nebularnoise/rp2040macro/models/base.FCStd

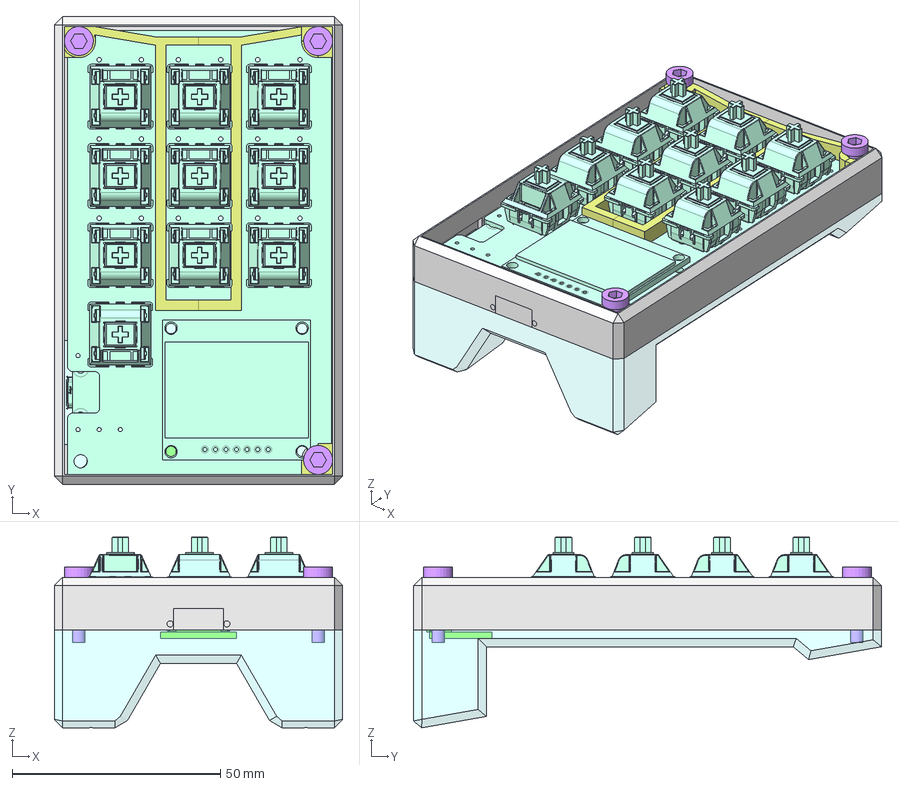
[picture p1: CAD file, 2022-07-17]
models/base.FCStd
69.3 x 112.5 x 45.8 mm
Sides
Base
Support
USB_C_Module
Sides_usb_C
Base_usb_c
Column001
Column002
Column003
Screw001
Screw002
Screw003
macropad001
