nebularnoise/rp2040macro/models/screen-Part.step

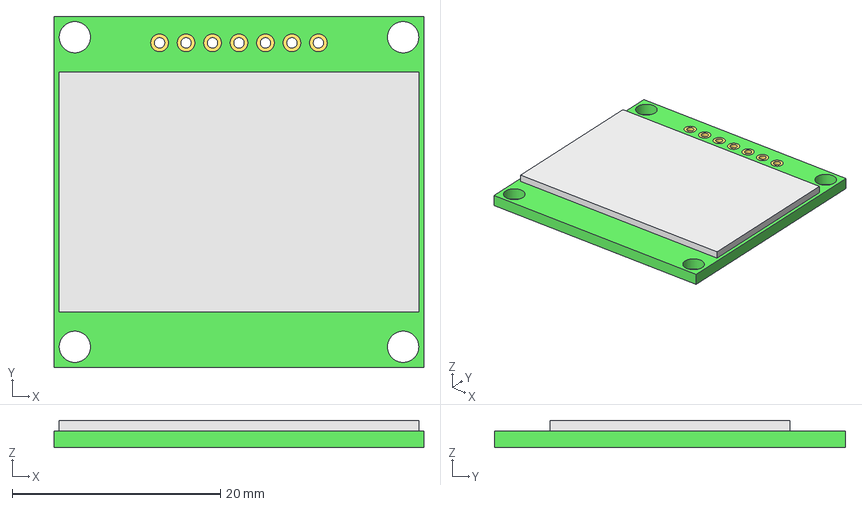
[picture p2: CAD file, 2022-07-10]
models/screen-Part.step
35.5 x 33.7 x 2.60 mm
