nebularnoise/rp2040macro/models/screen.FCStd

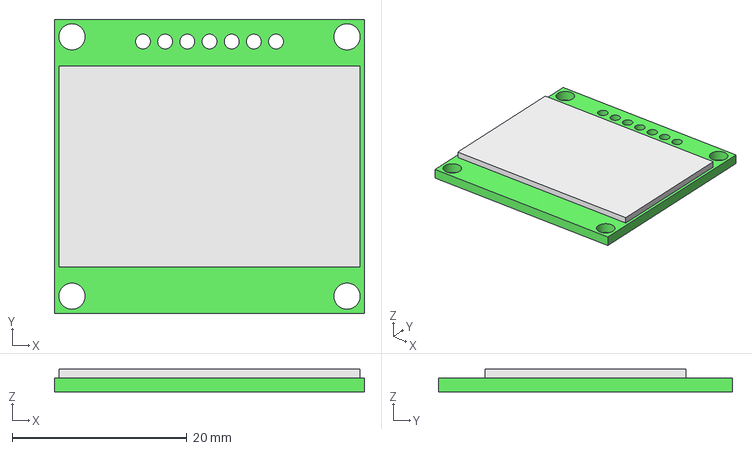
[picture p3: CAD file, 2022-06-10]
models/screen.FCStd
35.5 x 33.7 x 2.60 mm
