nebularnoise/rp2040macro/hardware/macropad.kicad_pcb

## KiCad design hardware/macropad.kicad_pcb (2022-07-10)

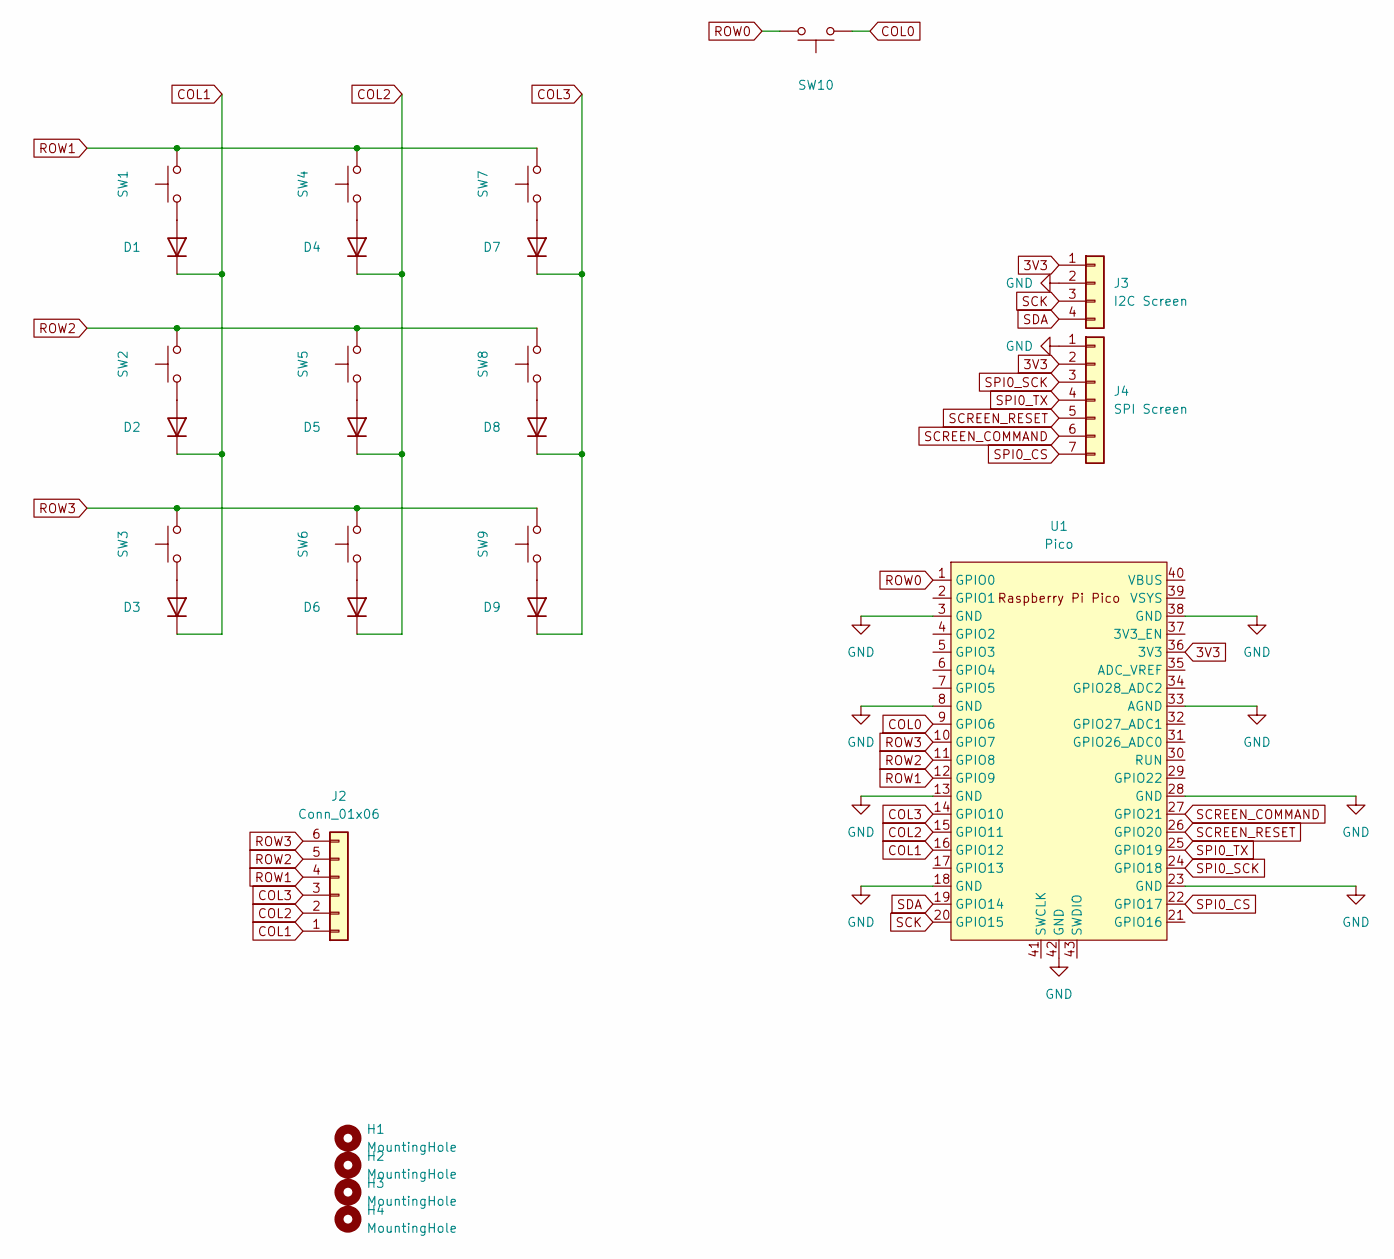
[picture p4: schematic macropad.kicad_sch]

Parts:
D1, D2, D3, D4, D5, D6, D7, D8, D9: D; D_DO-41_SOD81_P10.16mm_Horizontal
H1, H2, H3, H4: MountingHole; MountingHole_3.2mm_M3
J2: Conn_01x06; PinHeader_1x06_P2.54mm_Vertical
J3: I2C Screen; I2C_1.3inch_OLED
J4: SPI Screen; SPI_1.3inch_OLED
SW1, SW2, SW3, SW4, SW5, SW6, SW7, SW8, SW9, SW10: SW_Push; SW_Hotswap_Kailh_MX
U1: Pico; RPi_Pico_SMD_TH

Connections:
3V3: J3.1, J4.2, U1.36 (3V3)
COL0: SW10.2, U1.9 (GPIO6)
COL1: D1.1 (K), D2.1 (K), D3.1 (K), J2.1, U1.16 (GPIO12)
COL2: D4.1 (K), D5.1 (K), D6.1 (K), J2.2, U1.15 (GPIO11)
COL3: D7.1 (K), D8.1 (K), D9.1 (K), J2.3, U1.14 (GPIO10)
GND: J3.2, J4.1, U1.3 (GND), U1.8 (GND), U1.13 (GND), U1.18 (GND), U1.23 (GND), U1.28 (GND), U1.33 (AGND), U1.38 (GND), U1.42 (GND)
unnamed: D1.2 (A), SW1.2
unnamed: D2.2 (A), SW2.2
unnamed: D3.2 (A), SW3.2
unnamed: D4.2 (A), SW4.2
unnamed: D5.2 (A), SW5.2
unnamed: D6.2 (A), SW6.2
unnamed: D7.2 (A), SW7.2
unnamed: D8.2 (A), SW8.2
unnamed: D9.2 (A), SW9.2
ROW0: SW10.1, U1.1 (GPIO0)
ROW1: J2.4, SW1.1, SW4.1, SW7.1, U1.12 (GPIO9)
ROW2: J2.5, SW2.1, SW5.1, SW8.1, U1.11 (GPIO8)
ROW3: J2.6, SW3.1, SW6.1, SW9.1, U1.10 (GPIO7)
SCK: J3.3, U1.20 (GPIO15)
SCREEN_COMMAND: J4.6, U1.27 (GPIO21)
SCREEN_RESET: J4.5, U1.26 (GPIO20)
SDA: J3.4, U1.19 (GPIO14)
SPI0_CS: J4.7, U1.22 (GPIO17)
SPI0_SCK: J4.3, U1.24 (GPIO18)
SPI0_TX: J4.4, U1.25 (GPIO19)

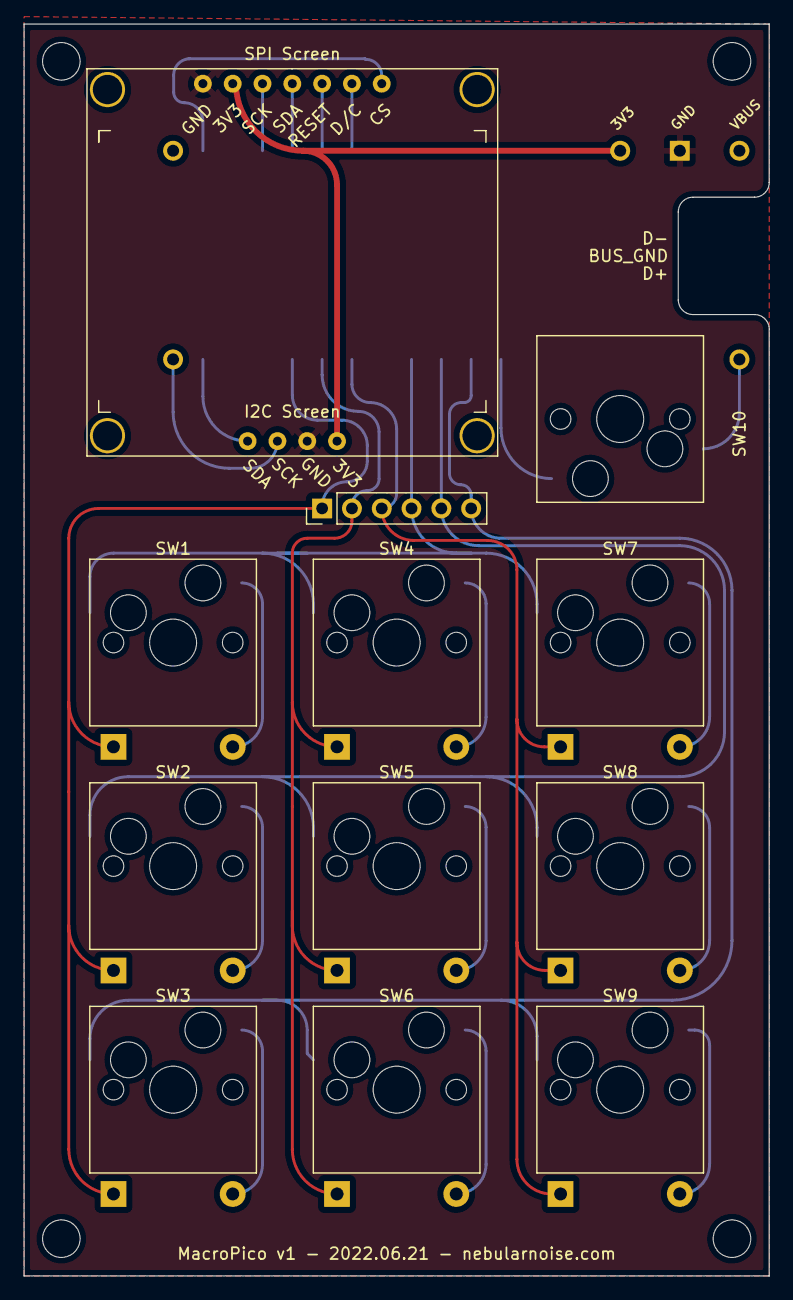
[picture p5: board macropad.kicad_pcb from above]

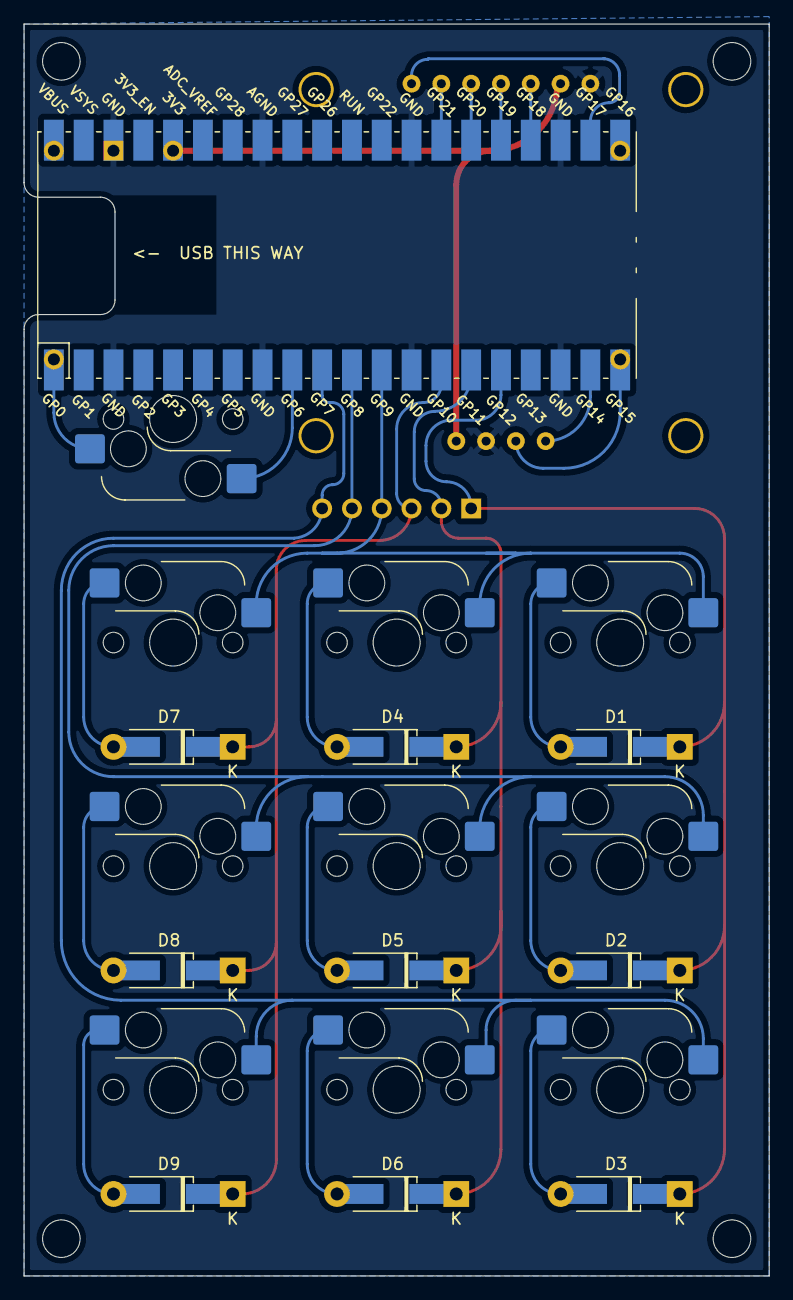
[picture p6: board macropad.kicad_pcb from below]

Board: 2 copper layers, 63.5 x 106.7 mm, 27 parts (10 on the bottom side), 26 nets.
