nebularnoise/rp2040macro/firmware/kmk/extensions/peg_rgb_matrix.py

import neopixel

from storage import getmount

from kmk.extensions import Extension
from kmk.handlers.stock import passthrough as handler_passthrough
from kmk.keys import make_key


class Color:
    OFF = [0, 0, 0]
    WHITE = [249, 249, 249]
    RED = [255, 0, 0]
    BLUE = [0, 0, 255]
    GREEN = [0, 255, 0]
    YELLOW = [255, 247, 0]
    ORANGE = [255, 77, 0]
    PURPLE = [255, 0, 242]
    TEAL = [0, 128, 128]
    PINK = [255, 0, 255]


class Rgb_matrix_data:
    def __init__(self, keys=[], underglow=[]):
        if len(keys) == 0:
            print('No colors passed for your keys')
            return
        if len(underglow) == 0:
            print('No colors passed for your underglow')
            return
        self.data = keys + underglow

    @staticmethod
    def generate_led_map(
        number_of_keys, number_of_underglow, key_color, underglow_color
    ):
        keys = [key_color] * number_of_keys
        underglow = [underglow_color] * number_of_underglow
        print('Rgb_matrix_data(keys={},\nunderglow={})'.format(keys, underglow))


class Rgb_matrix(Extension):
    def __init__(
        self,
        rgb_order=(1, 0, 2),  # GRB WS2812
        disable_auto_write=False,
        ledDisplay=[],
        split=False,
        rightSide=False,
    ):
        name = str(getmount('/').label)
        self.rgb_order = rgb_order
        self.disable_auto_write = disable_auto_write
        self.split = split
        self.rightSide = rightSide
        if name.endswith('L'):
            self.rightSide = False
        elif name.endswith('R'):
            self.rightSide = True
        if type(ledDisplay) is Rgb_matrix_data:
            self.ledDisplay = ledDisplay.data
        else:
            self.ledDisplay = ledDisplay

        make_key(
            names=('RGB_TOG',), on_press=self._rgb_tog, on_release=handler_passthrough
        )

    def _rgb_tog(self, *args, **kwargs):
        if self.enable:
            self.off()
        else:
            self.on()
        self.enable = not self.enable

    def on(self):
        if self.neopixel:
            self.setBasedOffDisplay()
            self.neopixel.show()

    def off(self):
        if self.neopixel:
            self.set_rgb_fill((0, 0, 0))

    def set_rgb_fill(self, rgb):
        if self.neopixel:
            self.neopixel.fill(rgb)
            if self.disable_auto_write:
                self.neopixel.show()

    def setBasedOffDisplay(self):
        if self.split:
            for i, val in enumerate(self.ledDisplay):
                if self.rightSide:
                    if self.keyPos[i] >= (self.num_pixels / 2):
                        self.neopixel[int(self.keyPos[i] - (self.num_pixels / 2))] = (
                            val[0],
                            val[1],
                            val[2],
                        )
                else:
                    if self.keyPos[i] <= (self.num_pixels / 2):
                        self.neopixel[self.keyPos[i]] = (val[0], val[1], val[2])
        else:
            for i, val in enumerate(self.ledDisplay):
                self.neopixel[self.keyPos[i]] = (val[0], val[1], val[2])

    def on_runtime_enable(self, sandbox):
        return

    def on_runtime_disable(self, sandbox):
        return

    def during_bootup(self, board):
        self.neopixel = neopixel.NeoPixel(
            board.rgb_pixel_pin,
            board.num_pixels,
            brightness=board.brightness_limit,
            pixel_order=self.rgb_order,
            auto_write=not self.disable_auto_write,
        )
        self.num_pixels = board.num_pixels
        self.keyPos = board.led_key_pos
        self.on()
        return

    def before_matrix_scan(self, sandbox):
        return

    def after_matrix_scan(self, sandbox):
        return

    def before_hid_send(self, sandbox):
        return

    def after_hid_send(self, sandbox):
        return

    def on_powersave_enable(self, sandbox):
        return

    def on_powersave_disable(self, sandbox):
        return
