nebularnoise/rp2040macro/(commit log)

2022-06-06 :tada: Init
    [macropad.kicad_pcb, macropad.kicad_sch]
2022-06-08 :sparkles: Add pico & screen
    [macropad.kicad_pcb, macropad.kicad_sch]
2022-06-09 :construction: Add headers for SPI screen also
    [macropad.kicad_pcb, macropad.kicad_sch]
2022-06-10 :sparkles: Add measurements
    [macropad.kicad_pcb]
2022-06-10 :construction: first draft 3d models
    [base.FCStd, screen.FCStd]
2022-06-13 :truck: Test different layout with pi pico in the back
    [macropad.kicad_pcb, macropad.kicad_sch]
2022-06-13 :construction: Some routing
    [macropad.kicad_pcb, macropad.kicad_sch]
2022-06-14 :construction: Edit pi pico to remove tht pads & add castellated pads for D+/D-
    [macropad.kicad_pcb, macropad.kicad_sch]
2022-06-14 :truck: Move screen headers, before changing footprint
    [macropad.kicad_pcb, macropad.kicad_sch]
2022-06-14 :construction: Change OLED footprint, reroute to accomodate. Delete USB pads, leave hole instead
    [macropad.kicad_pcb, macropad.kicad_sch]
2022-06-15 :construction: Move dimensions to user1 layer & adjust base model for easier drawing
    [base.FCStd, macropad.kicad_pcb]
2022-06-15 :construction: First draft front panel
    [macropad.kicad_pcb]
2022-06-16 :construction: Add dimension & lock holes
    [macropad.kicad_pcb]
2022-06-16 :construction: Revise models
    [base.FCStd]
2022-06-16 :sparkles: Much better parametric model for enclosure
    [base.FCStd]
2022-06-16 :construction: Integrate pico 3d model into project
    [macropad.kicad_pcb]
2022-06-16 :construction: Add columns to enclosure
    [base.FCStd]
2022-06-17 :construction: update 3d model -- get rid of assembly model
    same
2022-06-21 :truck: move front panel to separate files
    [macropad.kicad_pcb, macropad_front_panel.kicad_pcb, macropad_front_panel.kicad_sch]
2022-07-01 :sparkles: add screws to model
2022-07-06 :construction: add support between pcb & front panel
2022-07-07 :bug: Remove ledge around pi pico
2022-07-07 :sparkles: Adapt firmware to new board
2022-07-07 :bug: Fix garbage pixels
    [code.py]
2022-07-10 :zap: Prefer STEP models
    [macropad.kicad_pcb, screen-Part.step]
2022-07-10 :sparkles: improve usbc module model
    [base.FCStd]
2022-07-17 :bug: Fix usb Micro B spacing
    [base.FCStd]
